rahmani143/DD-Robocon-2025/(commit log)

2025-02-19 Rename Robot 1 - Risky Batman.zip to Robot 1 - Risky Batman STEP and STL.zip
2025-03-21 main_1.py
    The first set of instructions for the motors .. motor initializations done with stop n start code ..
    amends for the motor specific commands to be added
2025-03-26 update_1
    reduced the number of motors and applied servo
2025-04-25 including the lib for encoders
    including the lib for encoders
